jmcalister-eee/light-triggered-arduino-lamp-alarm/docs/images/KiCAD_Photos/Arduino_Lamp_Alarm_Full_KiCAD_Schematic.png

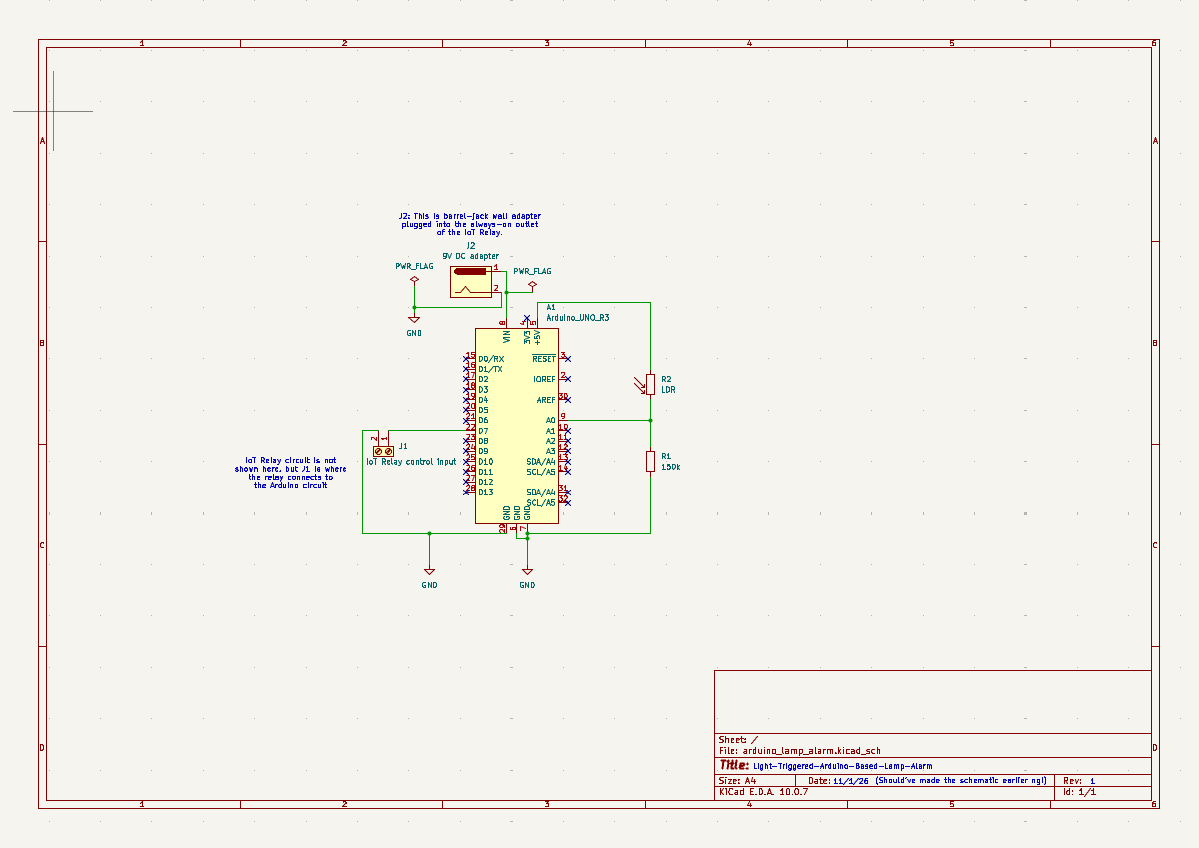
docs/images/KiCAD_Photos/Arduino_Lamp_Alarm_Full_KiCAD_Schematic.png
