jmcalister-eee/light-triggered-arduino-lamp-alarm/docs/images/KiCAD_Photos/Arduino_Lamp_Alarm_Zoomed_In_KiCAD_Schematic_Snippet.png

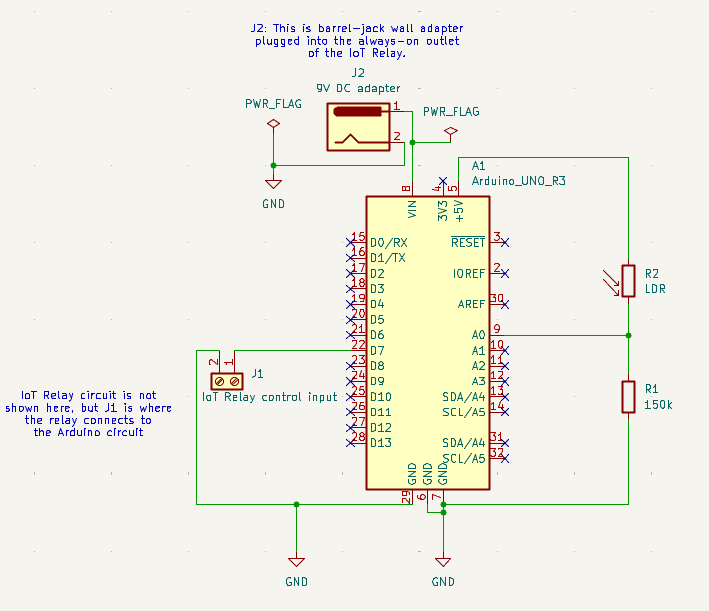
docs/images/KiCAD_Photos/Arduino_Lamp_Alarm_Zoomed_In_KiCAD_Schematic_Snippet.png
