jmcalister-eee/light-triggered-arduino-lamp-alarm/hardware/external_case/external_phone_case_v1.1.3mf

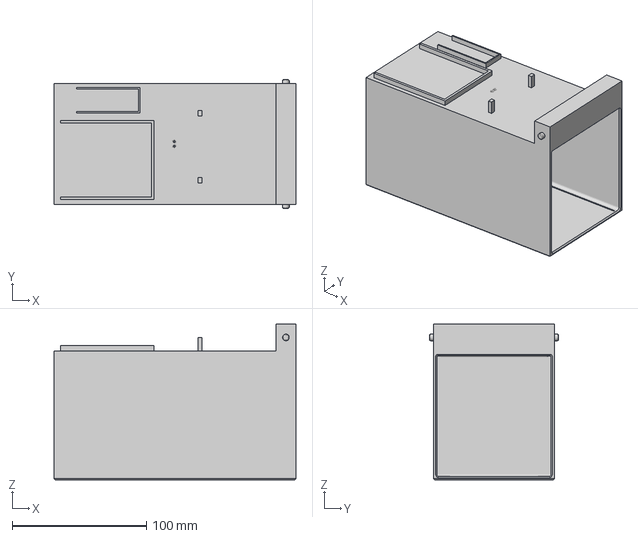
[picture p8: CAD file, 2026-11-01]
hardware/external_case/external_phone_case_v1.1.3mf
180.0 x 96.0 x 116.0 mm
