jmcalister-eee/light-triggered-arduino-lamp-alarm/(list of files, cad)

Other CAD files:
hardware/external_case/external_phone_case_v1.1.f3d
hardware/external_case/external_phone_case_v1.1.stl
