jmcalister-eee/light-triggered-arduino-lamp-alarm/hardware/schematic/arduino_lamp_alarm.pdf

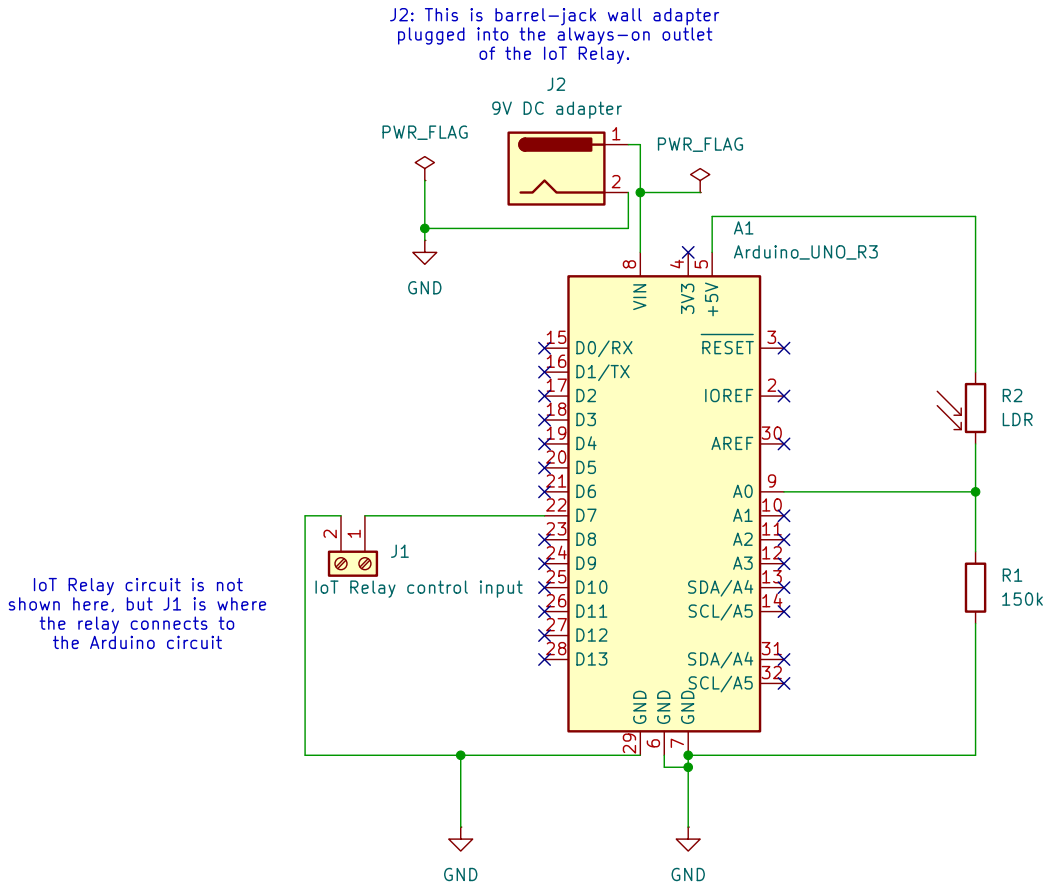
[picture p9: page 1]

J2: This is barrel-jack wall adapter
plugged into the always-on outlet of the IoT Relay.
Arduino_UNO_R3 GND

IoT Relay circuit is not shown here, but J1 is where

the relay connects to
the Arduino circuit

Light-Triggered-Arduino-Based-Lamp-Alarm

Size: A4 | 11/1/26 (Should've made the schematic earlier ngl) | Rev:
KiCad E.D.A. 10.0.7 | | Id: 1/1
