jmcalister-eee/light-triggered-arduino-lamp-alarm/hardware/schematic/arduino_lamp_alarm.kicad_sch

## KiCad design hardware/schematic/arduino_lamp_alarm.kicad_sch (2026-11-01)

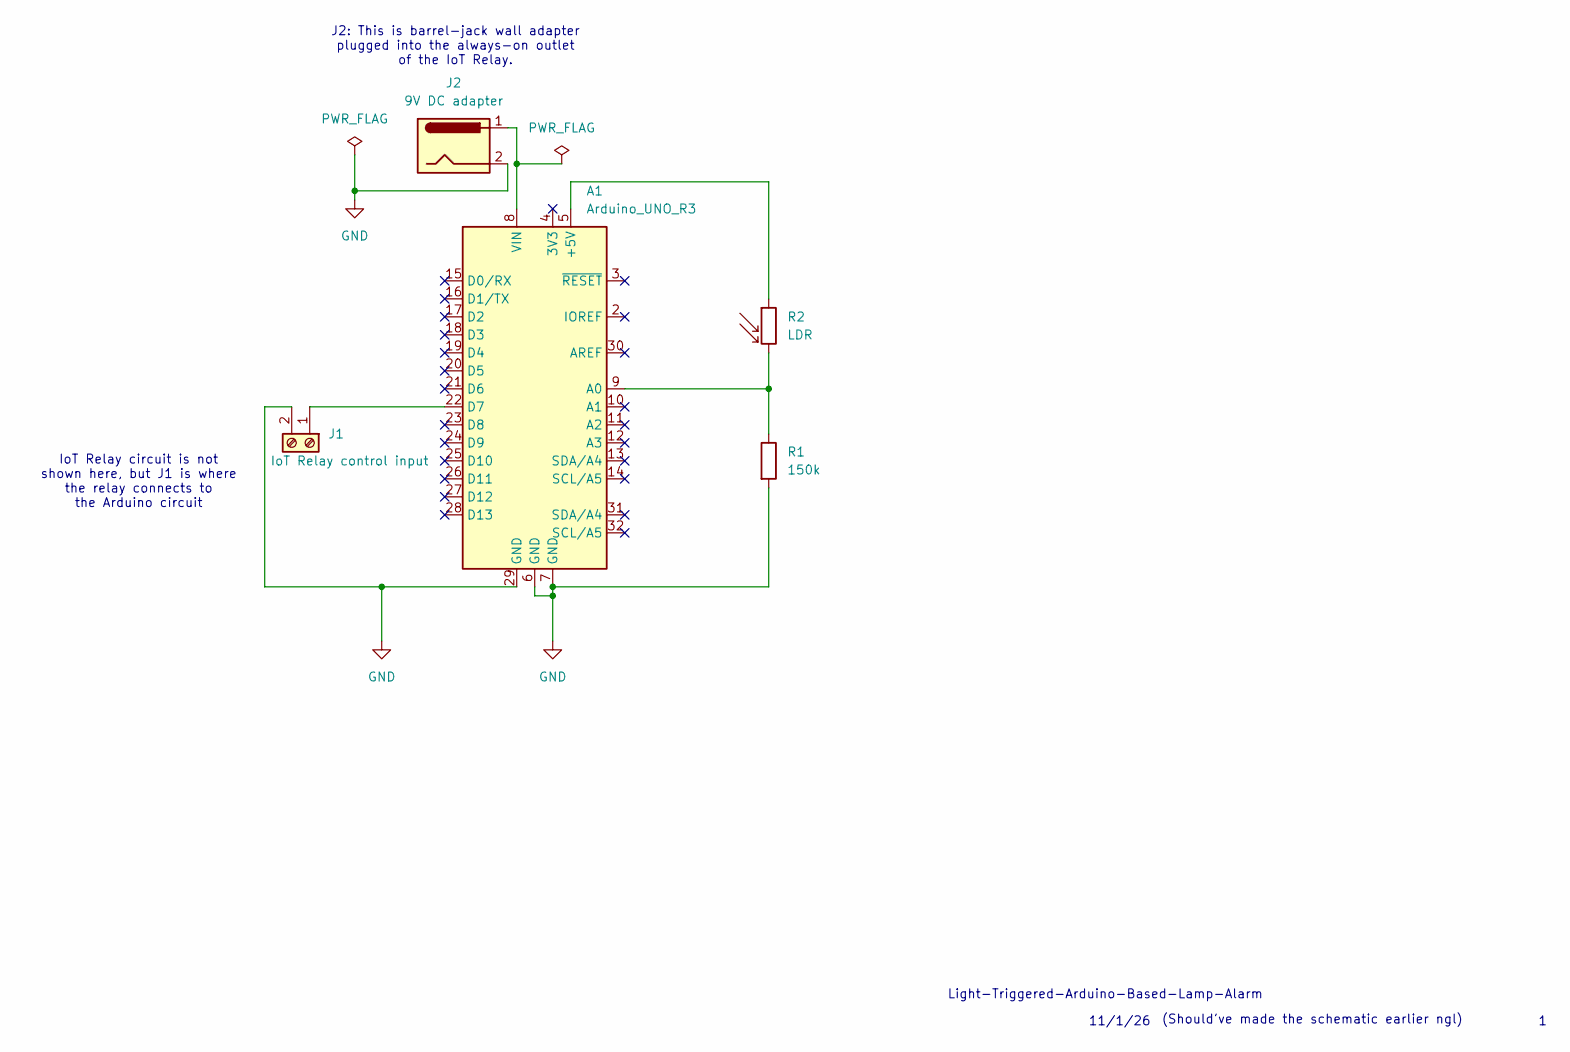
[picture p10: schematic arduino_lamp_alarm.kicad_sch]

Parts:
A1: Arduino_UNO_R3
J1: IoT Relay control input
J2: 9V DC adapter
R1: 150k
R2: LDR

Connections:
GND: A1.6 (GND), A1.7 (GND), A1.29 (GND), J1.2, J2.2, R1.2
unnamed: A1.5 (+5V), R2.1
unnamed: A1.8 (VIN), J2.1
unnamed: A1.9 (A0), R1.1, R2.2
unnamed: A1.22 (D7), J1.1

Notes on the sheet:
Light-Triggered-Arduino-Based-Lamp-Alarm
(Should've made the schematic earlier ngl)
IoT Relay circuit is not shown here, but J1 is where the relay connects to the Arduino circuit
J2: This is barrel-jack wall adapter plugged into the always-on outlet of the IoT Relay.
11/1/26
