jmcalister-eee/light-triggered-arduino-lamp-alarm/(commit log)

2026-11-01 Added project and schematic photos
    Images of project. Includes external case, schematic, and final working design.
2026-11-01 Added Arduino Code
    Added logic to program the Arduino with.
2026-11-01 Added the external case's CAD files
    [external_phone_case_v1.1.3mf, external_phone_case_v1.1.f3d, external_phone_case_v1.1.stl]
2026-11-01 Added the KiCAD schematic files
    [arduino_lamp_alarm.kicad_sch]
2026-11-02 Video for Demo 1 of Arduino Lamp Alarm
2026-11-03 Changed external_phone_case files
    [external_phone_case_v1.1.3mf, external_phone_case_v1.1.f3d, external_phone_case_v1.1.stl]
