jmcalister-eee/light-triggered-arduino-lamp-alarm/docs/images/Arduino_Firmware_Logic_Explanation.jpg

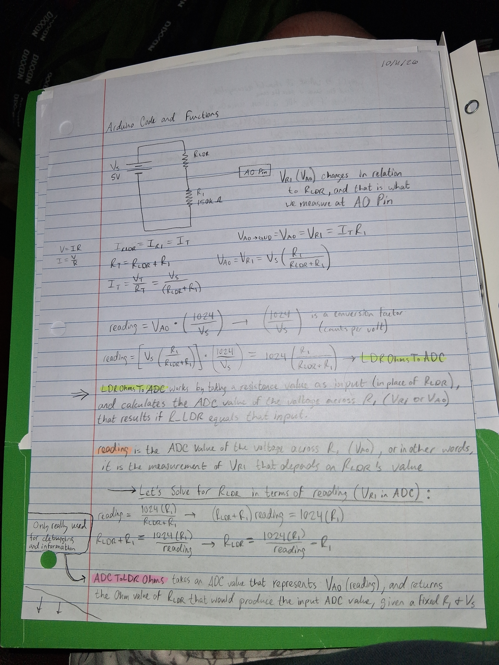
docs/images/Arduino_Firmware_Logic_Explanation.jpg
