jmcalister-eee/light-triggered-arduino-lamp-alarm/docs/images/Phone_Enclosure_Later_Iteration.jpg

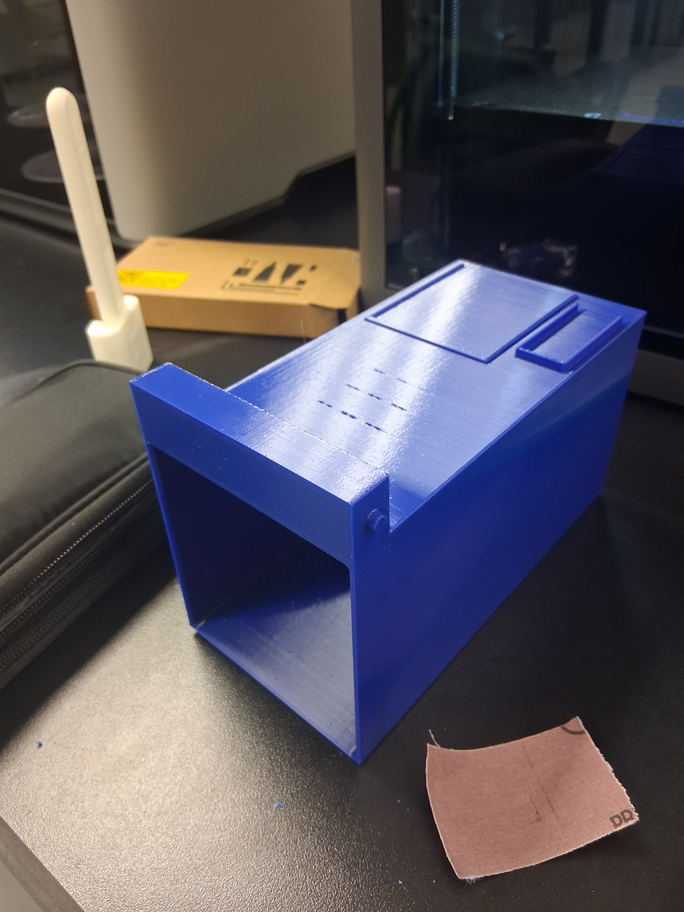
[picture p4: docs/images/Phone_Enclosure_Later_Iteration.jpg]
docs/images/Phone_Enclosure_Later_Iteration.jpg
